ASL-Robot/pcb-design/PCB_BOM.xlsx

Sheet: BOM
 | Digikey Item Number | Name | Function | Quantity per PCB | 3xQuantity Per PCB | Unit Price | Total Cost
Voltage Regulators | 1028-1214-1-ND | RT7258 | 8A Switching Regulator | 13 | 39 | $0.97 | $37.81
 | IRF7821PBFCT-ND | IRF7821 | N-Ch MOSFET | 13 | 39 | $0.92 | $35.69
 | 311-2054-1-ND | 47 uF Capacitor | Reservoir Capacitors | 38 | 114 | $0.46 | $52.85
 | 445-11739-1-ND | 22 uF Capacitor | Input Filter Capacitor | 13 | 39 | $0.50 | $19.50
 | 490-11607-1-ND | 1 uF Capcaitor | Vcc Decoupling & Boot Capacitors | 26 | 78 | $0.22 | $17.32
 | 595-1400-1-ND | 10 uH Inductor |  | 13 | 39 | $0.74 | $29.02
 | RHM60.4KCJCT-ND | 60.4k Resistor | 3.3 V Feedback Resistor (R1) | 1 | 3 | $0.10 | $0.30
 | RHM19.6KCJCT-ND | 19.6k Resistor | 3.3 V Feedback Resistor (R2) | 1 | 3 | $0.10 | $0.30
 | RHM82.0KCJCT-ND | 82k Resistor | 5 V Feedback Resistor (R1) | 1 | 3 | $0.10 | $0.30
 | RHM16.0KCJCT-ND | 16k Resistor | 5 V Feedback Resistor (R2) | 1 | 3 | $0.10 | $0.30
 | RHM133KCJCT-ND | 133k Resistor | 7.4 V Feedback Resistor (R1) | 2 | 6 | $0.10 | $0.60
 | RHM16.2KCJCT-ND | 16.2k Resistor | 7.4 V Feedback Resistor (R2) | 2 | 6 | $0.10 | $0.60
 | RHM121KCJCT-ND | 121k Resistor | 11.1 V Feedback Resistor (R1) | 1 | 3 | $0.10 | $0.30
 | RHM9.53KCJCT-ND | 9.53k Resistor | 11.1 V Feedback Resistor (R2) | 1 | 3 | $0.10 | $0.30
 | RHM127KCJCT-ND | 127k Resistor | 12.0 V Feedback Resistor (R1) | 8 | 24 | $0.10 | $2.40
 | RHM9.10KCJCT-ND | 9.1k Resistor | 12.0 V Feedback Resistor (R2) | 8 | 24 | $0.10 | $2.40
 | RHM390CJCT-ND | 390 | EN Resistor Network (R1) | 1 | 3 | $0.10 | $0.30
 | RHM100CJCT-ND | 100 | EN Resistor Network (R2) | 1 | 3 | $0.10 | $0.30
Circuit Protection | 486-1258-ND | Fuse Holder |  | 18 | 54 | $0.64 | $34.56
 | F2392-ND | 1A Fuse | 5V & 3V rails | 2 | 6 | $0.36 | $2.16
 | F2393-ND | 2A Fuse | 11.1 V Pin Headers | 2 | 6 | $0.36 | $2.16
 | F2682-ND | 3A Fuse | 7.4V Pin Headers | 6 | 18 | $0.40 | $7.15
 | 486-1791-ND | 10A Fuse | 12V Rails | 8 | 24 | $1.11 | $26.74
 | 732-9776-1-ND | 14V vwm TVS Diode | 12V Rail Clamping Protection | 8 | 24 | $0.30 | $7.20
 | 732-9774-1-ND | 12V vwm TVS Diode | 11.1V Rail Clamping Protection | 1 | 3 | $0.33 | $0.99
 | 732-9734-1-ND | 8V vwm TVS Diode | 7.4 V Rail Clamping Protection | 2 | 6 | $0.33 | $1.98
 | 732-9764-1-ND | 5V vwm TVS Diode | 5 V Rail Clamping Protection | 1 | 3 | $0.33 | $0.99
 | SMBJ3V3-E3/52GICT-ND | 3.3V vwm TVS Diode | 3.3V Rail Clamping Protection | 1 | 3 | $0.41 | $1.23
 | 404-1037-1-ND |  | Status LED's | 31 | 93 | $0.27 | $24.70
 | RHM750CJCT-ND | 750 Resistor | Power Status LED Resistor | 13 | 39 | $0.10 | $3.90
 | RHM499CJCT-ND | 499 Resistor | 12V Rail Status LED Resistor | 8 | 24 | $0.05 | $1.30
 | RHM453CJCT-ND | 453 Resistor | 11.1V Rail Status LED Resistor | 2 | 6 | $0.10 | $0.60
 | RHM267CJCT-ND | 267 Resistor | 7.4 V Rail Status LED Resistor | 6 | 18 | $0.10 | $1.80
 | RHM147CJCT-ND | 147 Resistor | 5V Rail Status LED Resistor | 1 | 3 | $0.10 | $0.30
 | RHM59CJCT-ND | 59 Resistor | 3.3V Rail Status LED Resistor | 1 | 3 | $0.10 | $0.30
 | IPD068P03L3 GCT-ND | P-CH Mosfet | Reverse Current Protection | 5 | 15 | $0.76 | $11.40
Power Relay Switch | A122116-ND | Relay | Power Relay | 1 | 3 | $43.04 | $129.12
 | A121979-ND | Seal | Power Relay Wire Seal | 4 | 12 | $0.20 | $2.40
 | A106529-ND | Plug | Connector Plug for Relay | 1 | 3 | $1.85 | $5.55
 | A105220CT-ND | Crimp | Connector Socket for Relay | 4 | 12 | $0.34 | $4.08
 | BH9VW-ND | Battery Holder | 9 V Battery Casing | 1 | 3 | $1.43 | $4.29
 | 432-1086-ND | Switch | On/Off Switch for Relay | 1 | 3 | $4.68 | $14.04
 | A100746CT-ND | Crimp | O-Ring Load Connector | 3 | 9 | $0.57 | $5.13
Signal Circuit | Can only get from TI (http://www.ti.com/product/msp432p401r/samplebuy) | MSP432 | Micro-controller | 2 | 6 | $7.60 | $45.60
 | 296-1232-1-ND | Transceivever | Tri-state Buffer | 2 | 6 | $0.50 | $3.00
 | 587-1624-1-ND | 4.7 uH Inductor |  | 2 | 6 | $0.27 | $1.62
 | 1276-1148-1-ND | 10uF Capacitor | Ceramic | 2 | 6 | $0.23 | $1.38
 | 490-1805-1-ND | 4.7 uF Capacitor | Ceramic | 2 | 6 | $0.25 | $1.50
 | 490-11607-1-ND | 1 uF Capacitor | Ceramic | 4 | 12 | $0.30 | $3.60
 | 399-1249-1-ND | 100 nF Capacitor | Ceramic | 10 | 30 | $0.07 | $2.16
 | RHM200CJCT-ND | 200 Ω Resistor |  | 1 | 3 | $0.10 | $0.30
 | RHM10.0KCJCT-ND | 10K Ω Resistor |  | 1 | 3 | $0.10 | $0.30
 | 2863S-08-ND | 8 POS | PCB Pin Socket | 2 | 6 | $1.39 | $8.34
 | S5901-03-ND | 3 POS | PCB Pin Socket | 1 | 3 | $8.40 | $25.20
Connectors | WM19010-ND | Wire Housing | XL-320 Cable | 12 | 36 | $0.11 | $4.10
 | WM19005-ND | PCB Header | XL-320 Cable | 6 | 18 | $0.18 | $3.17
 | WM4561CT-ND | Crimp | XL-320 Cable | 36 | 108 | $0.04 | $4.28
 | WM18874-ND | Wire Housing | MX/AX Cable | 32 | 96 | $0.23 | $22.44
 | WM18887-ND | PCB Header | MX/AX Cable | 4 | 12 | $0.47 | $5.68
 | WM18889CT-ND | Crimp | MX/AX Cable | 96 | 288 | $0.06 | $16.31
 | 277-1860-ND | 4-Pos (3.5) Terminal Block | Relay to Voltage Regulator Input Connection | 3 | 9 | $0.75 | $6.75
 | 277-6699-ND | 1-Pos Terminal Block | PCB Ground Connection | 1 | 3 | $3.80 | $11.40
 | 311-0.0ERCT-ND | 0 Ω Resistor | PCB Track Jumpers | 16 | 48 | $0.02 | $0.84
 |  |  |  |  |  | $220.87 | $662.62

Sheet: Inductor-Resistor Calculations
Vin Max (V) | I Max (A) | Frequency (kHz)
24 | 8 | 600
Inductance Calculation |  |  | Feedback Resistor Network Calculations
Vout | Min. Inductance (uH) |  | R1 Calculation |  |  |  | R2 Calculation |  |  | Vout Calculation
3.3 | 2.47 |  | R2 (kΩ) | Vout | R1 (kΩ) |  | R1 (kΩ) | Vout | R2 (kΩ) | R1 (kΩ) | R2 (kΩ) | Vout
5 | 3.44 |  | 20 | 3.3 | 61.68316832 |  | 62 | 3.3 | 20.10272873 | 60.4 | 19.6 | 3.297959184
7.4 | 4.44 |  | 16 | 5 | 83.00990099 |  | 93 | 5 | 17.92557252 | 82 | 16 | 4.949
11.1 | 5.18 |  | 16 | 7.4 | 130.5346535 |  | 133 | 7.4 | 16.30218447 | 133 | 16.2 | 7.441580247
12 | 5.21 |  | 9.1 | 11.1 | 115.9123762 |  | 121 | 11.1 | 9.499417023 | 121 | 9.53 | 11.06697167
 |  |  | 9.1 | 12 | 126.0485149 |  |  | 12 | 0 | 127 | 9.1 | 12.08448352
 |  |  |  |  |  |  |  |  |  | Final Values
 |  |  | Status Led Resistor Calculation
 |  |  | Vdiode (V) | I diode (mA) |  | Vcc | Resistor ()
 |  |  | 2.1 | 20 |  | 24 | 1095
 |  |  |  |  |  | 15 | 645
 |  |  |  |  |  | 12 | 495
 |  |  |  |  |  | 11.1 | 450
 |  |  |  |  |  | 7.4 | 265
 |  |  |  |  |  | 5 | 145
 |  |  |  |  |  | 3.3 | 60

Sheet: Current(A) Calculations
Motor | Rec. Voltage (V) | Max Current Draw (A) | Quantity | Total Current Draw (A)
XL-320 | 7.4 | 0.6 | 22 | 13.2
AX-12 | 11.1 | 1.5 | 2 | 3
MX-28 | 12 | 1.4 | 2 | 2.8
MX-64 | 12 | 4.1 | 2 | 8.2
MX-106 | 12 | 5.2 | 10 | 52
 |  |  |  | 79.2
Voltage | Total Current Draw | # of 8A Voltage Regulators
7.4 | 13.2 | 2
11.1 | 3 | 1
12 | 63 | 8
