ASL-Robot/pcb-design/PCBFinal/PCBFinal.kicad_pcb

## KiCad design PCBFinal/PCBFinal.kicad_pcb (2016-05-11)

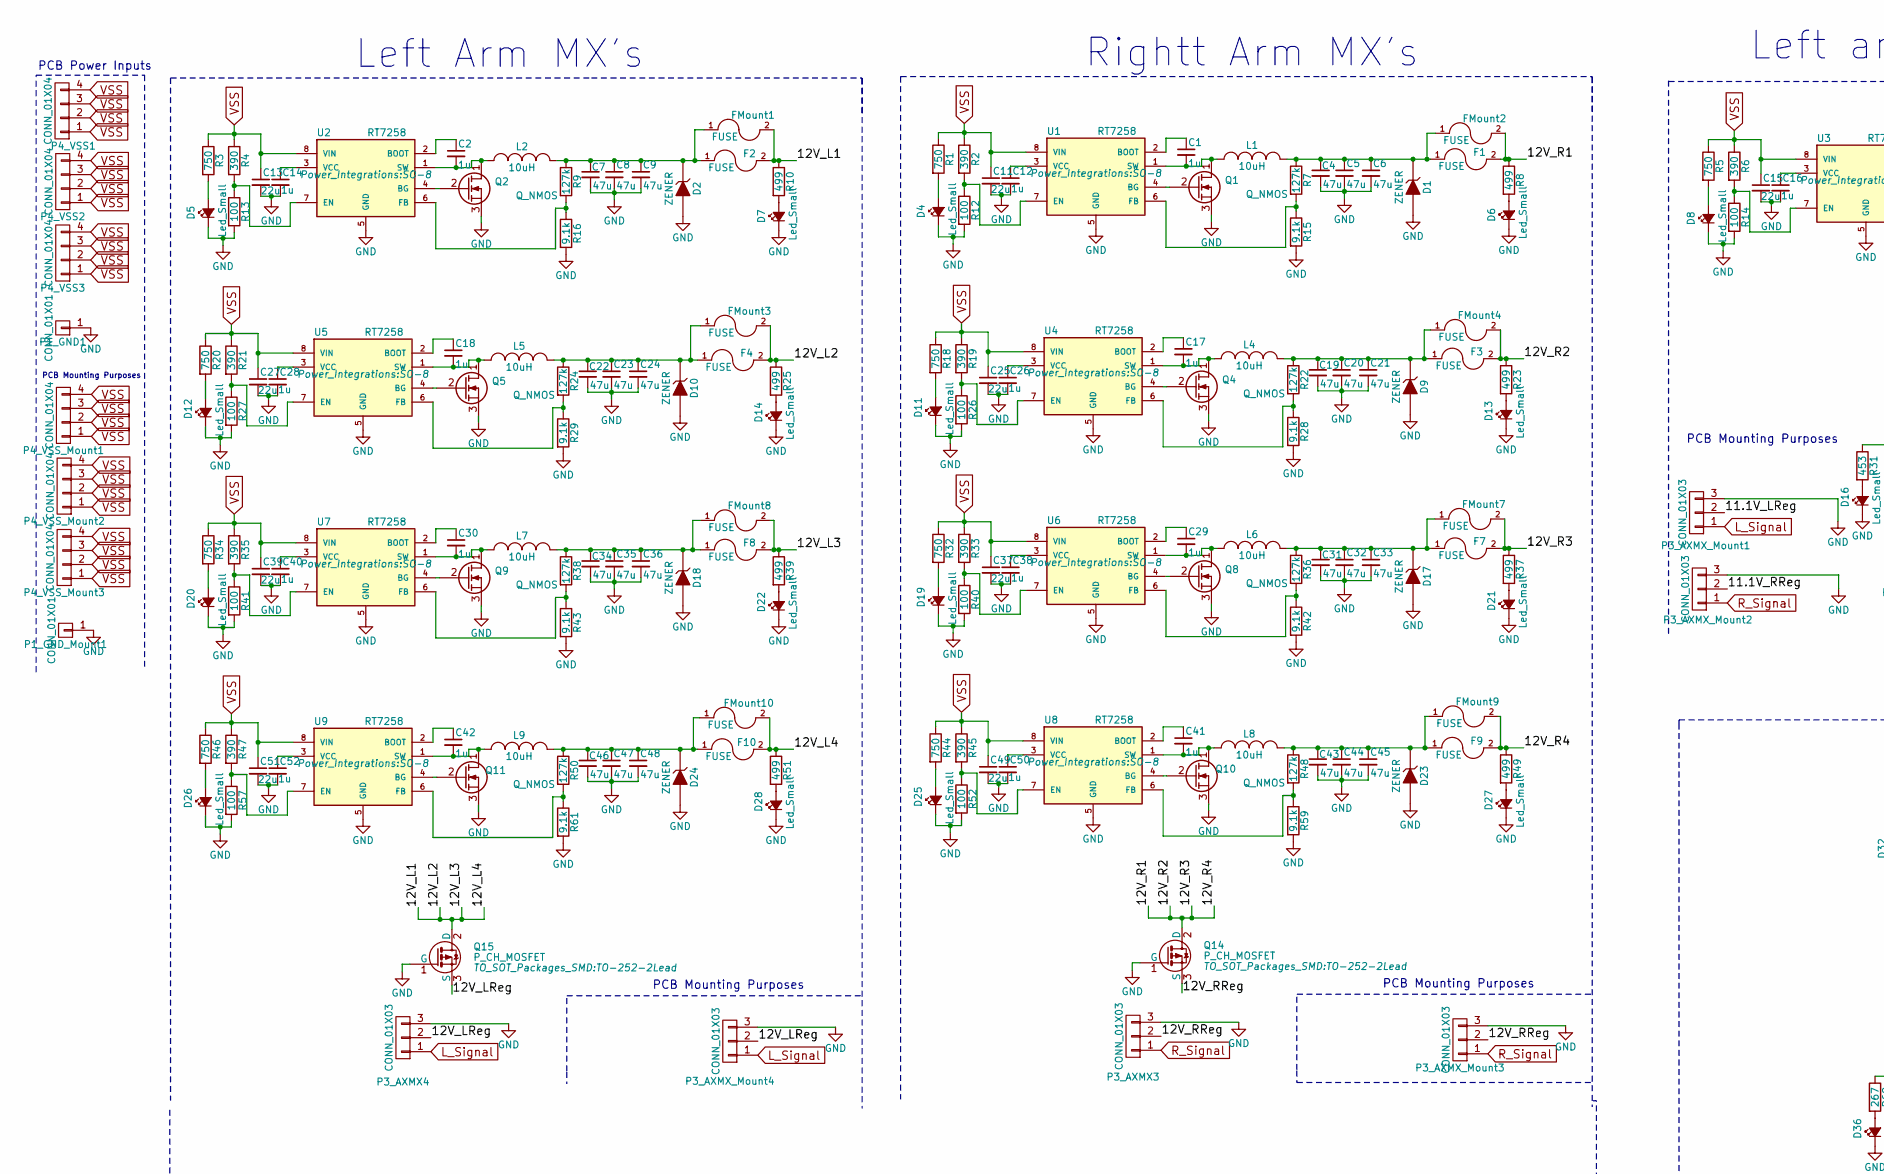
[picture p1: schematic PCBFinal.sch, part in row 1, column 1]

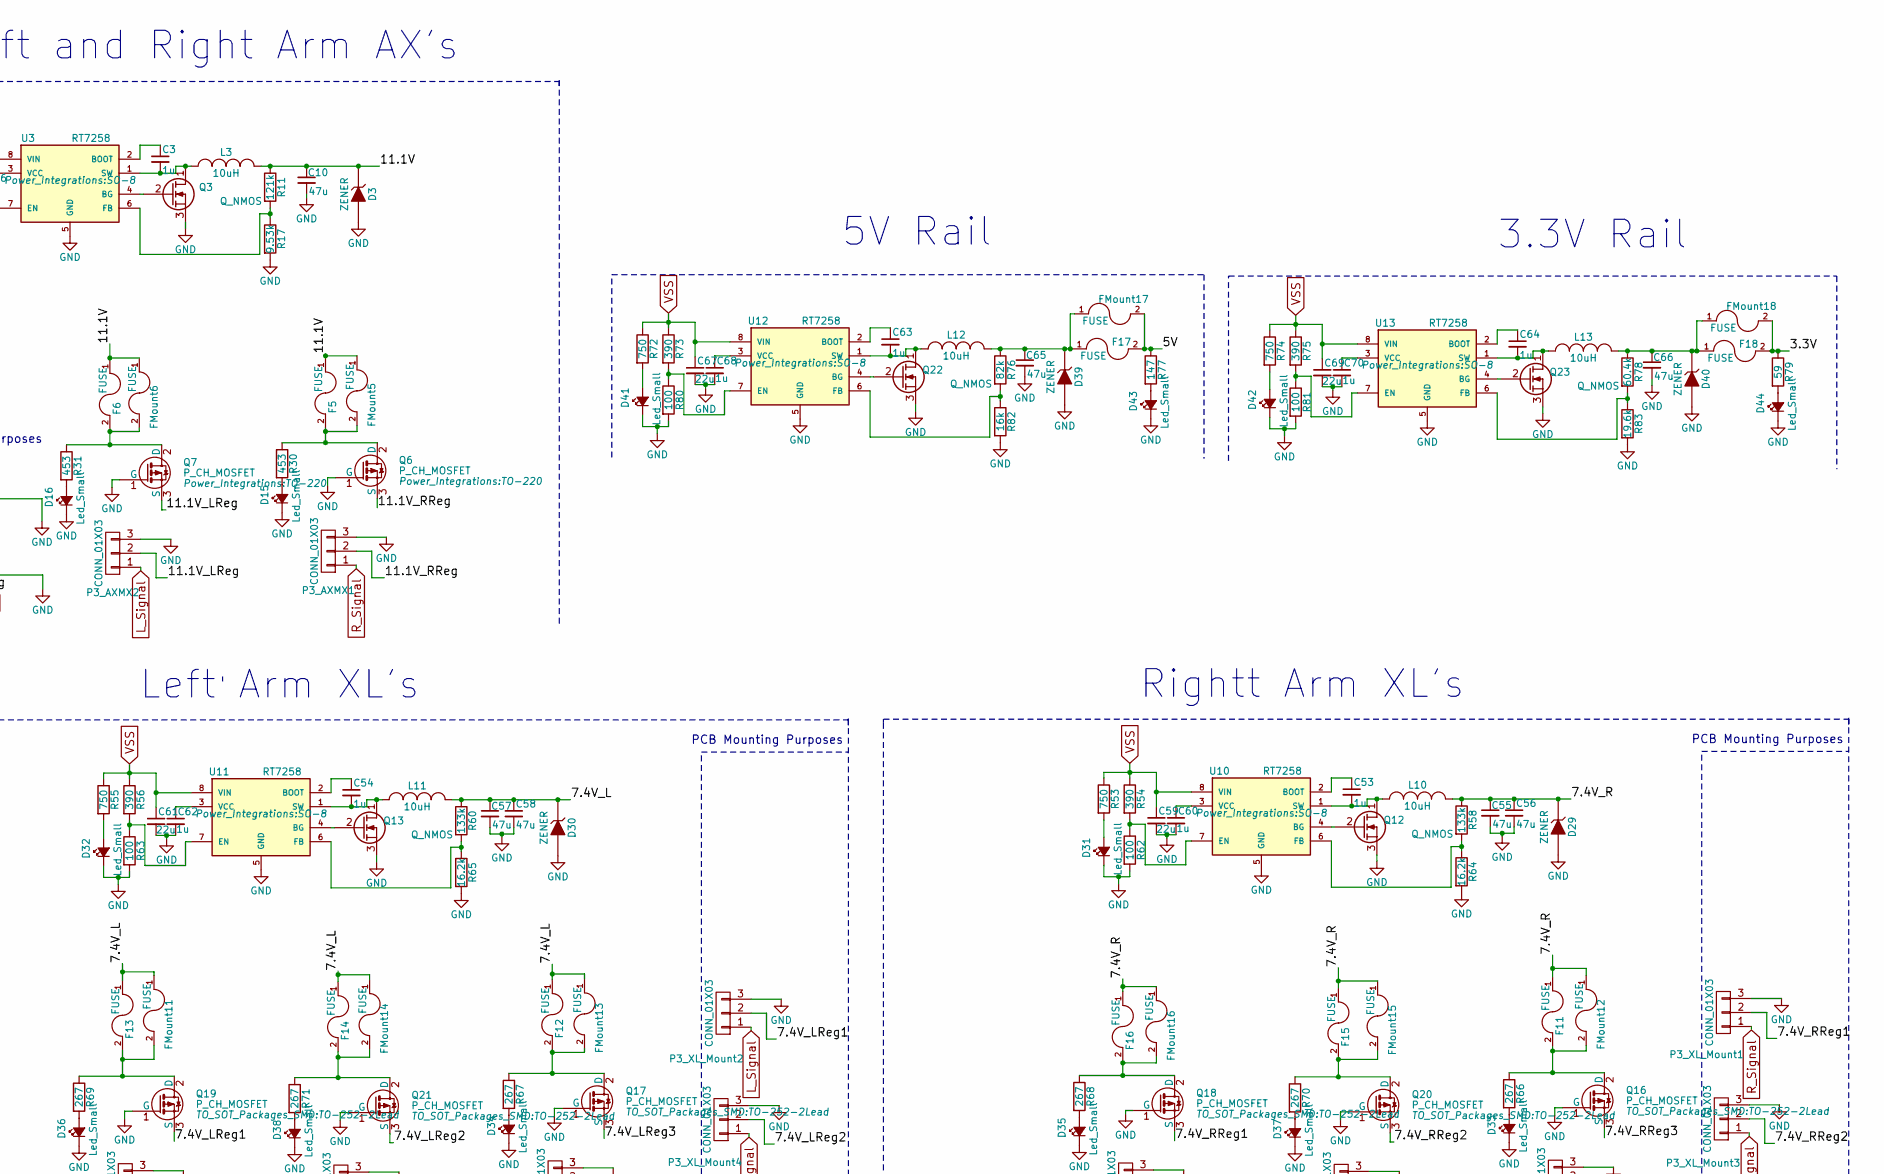
[picture p2: schematic PCBFinal.sch, part in row 1, column 2]

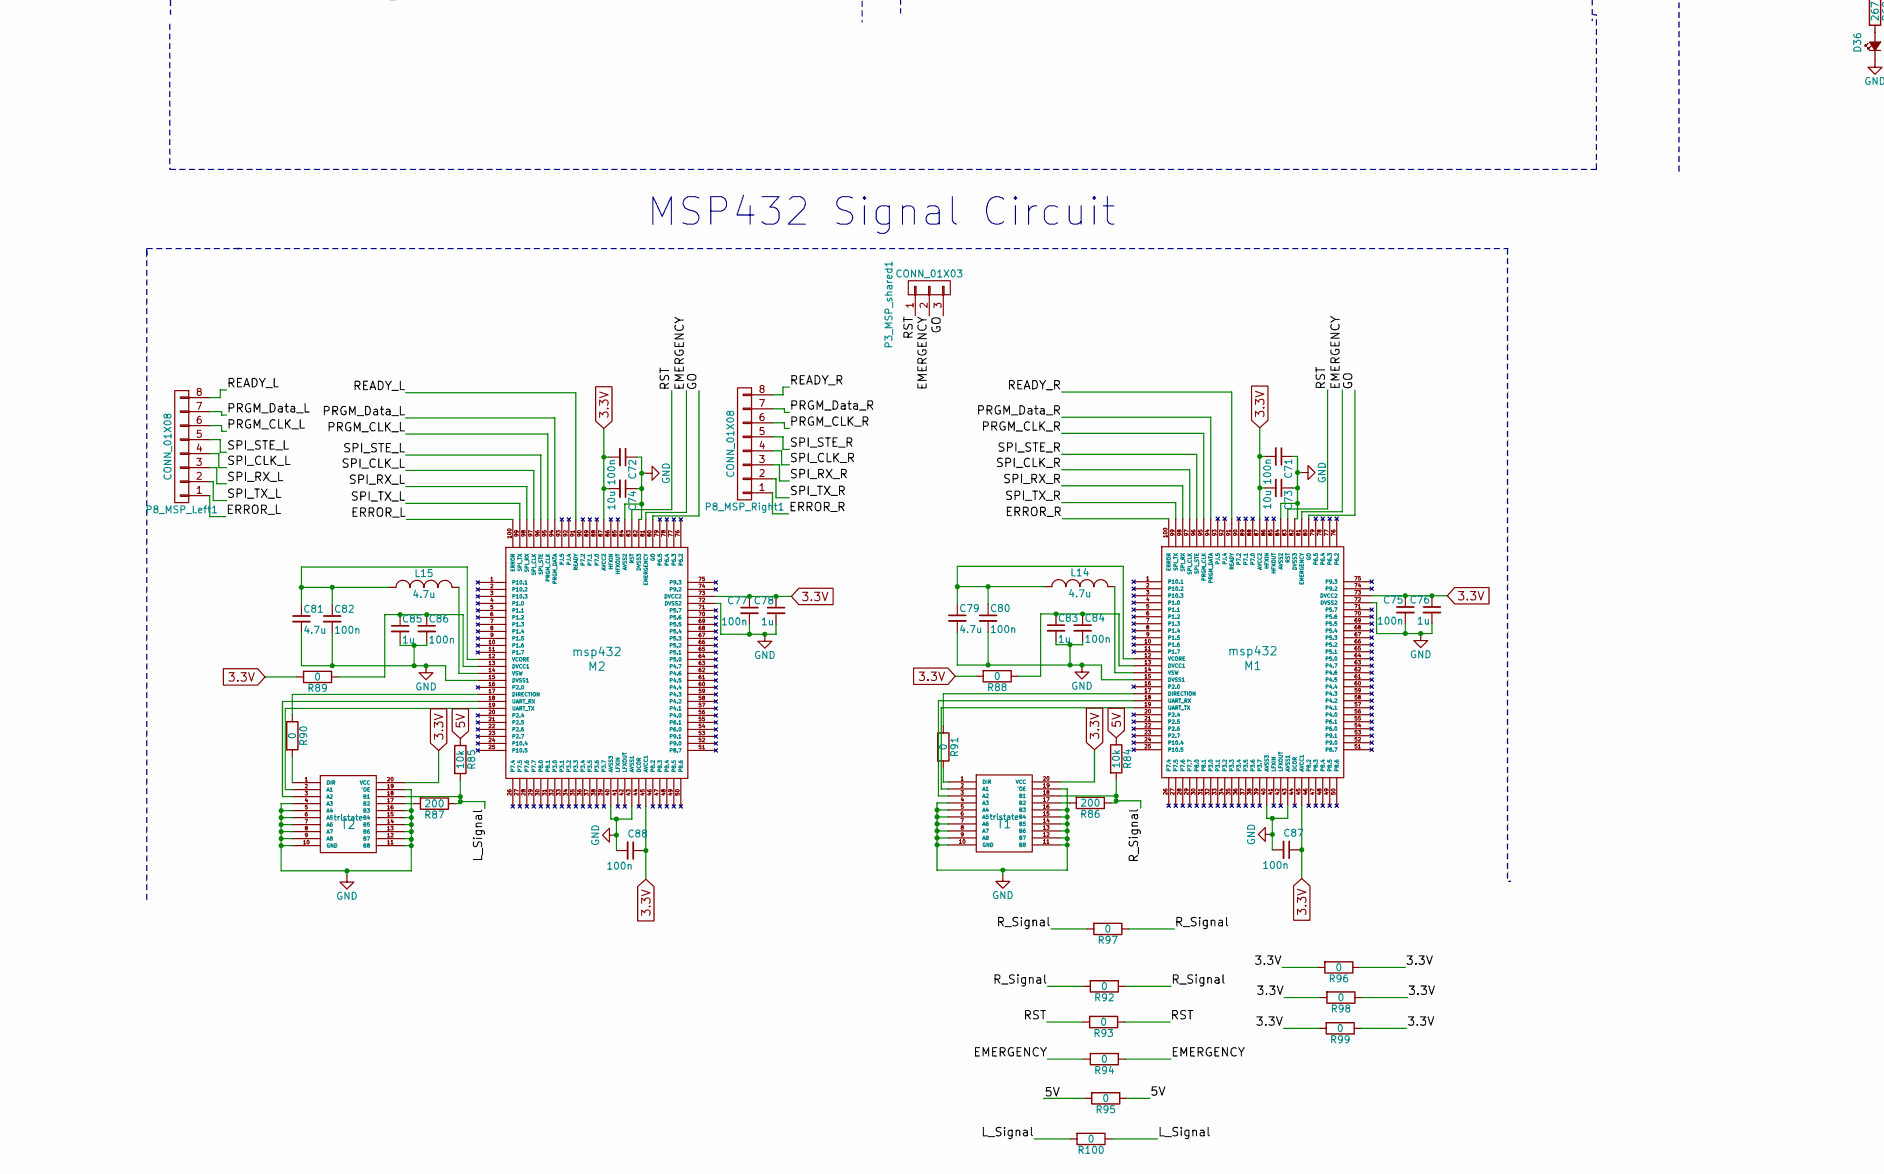
[picture p3: schematic PCBFinal.sch, part in row 2, column 1]

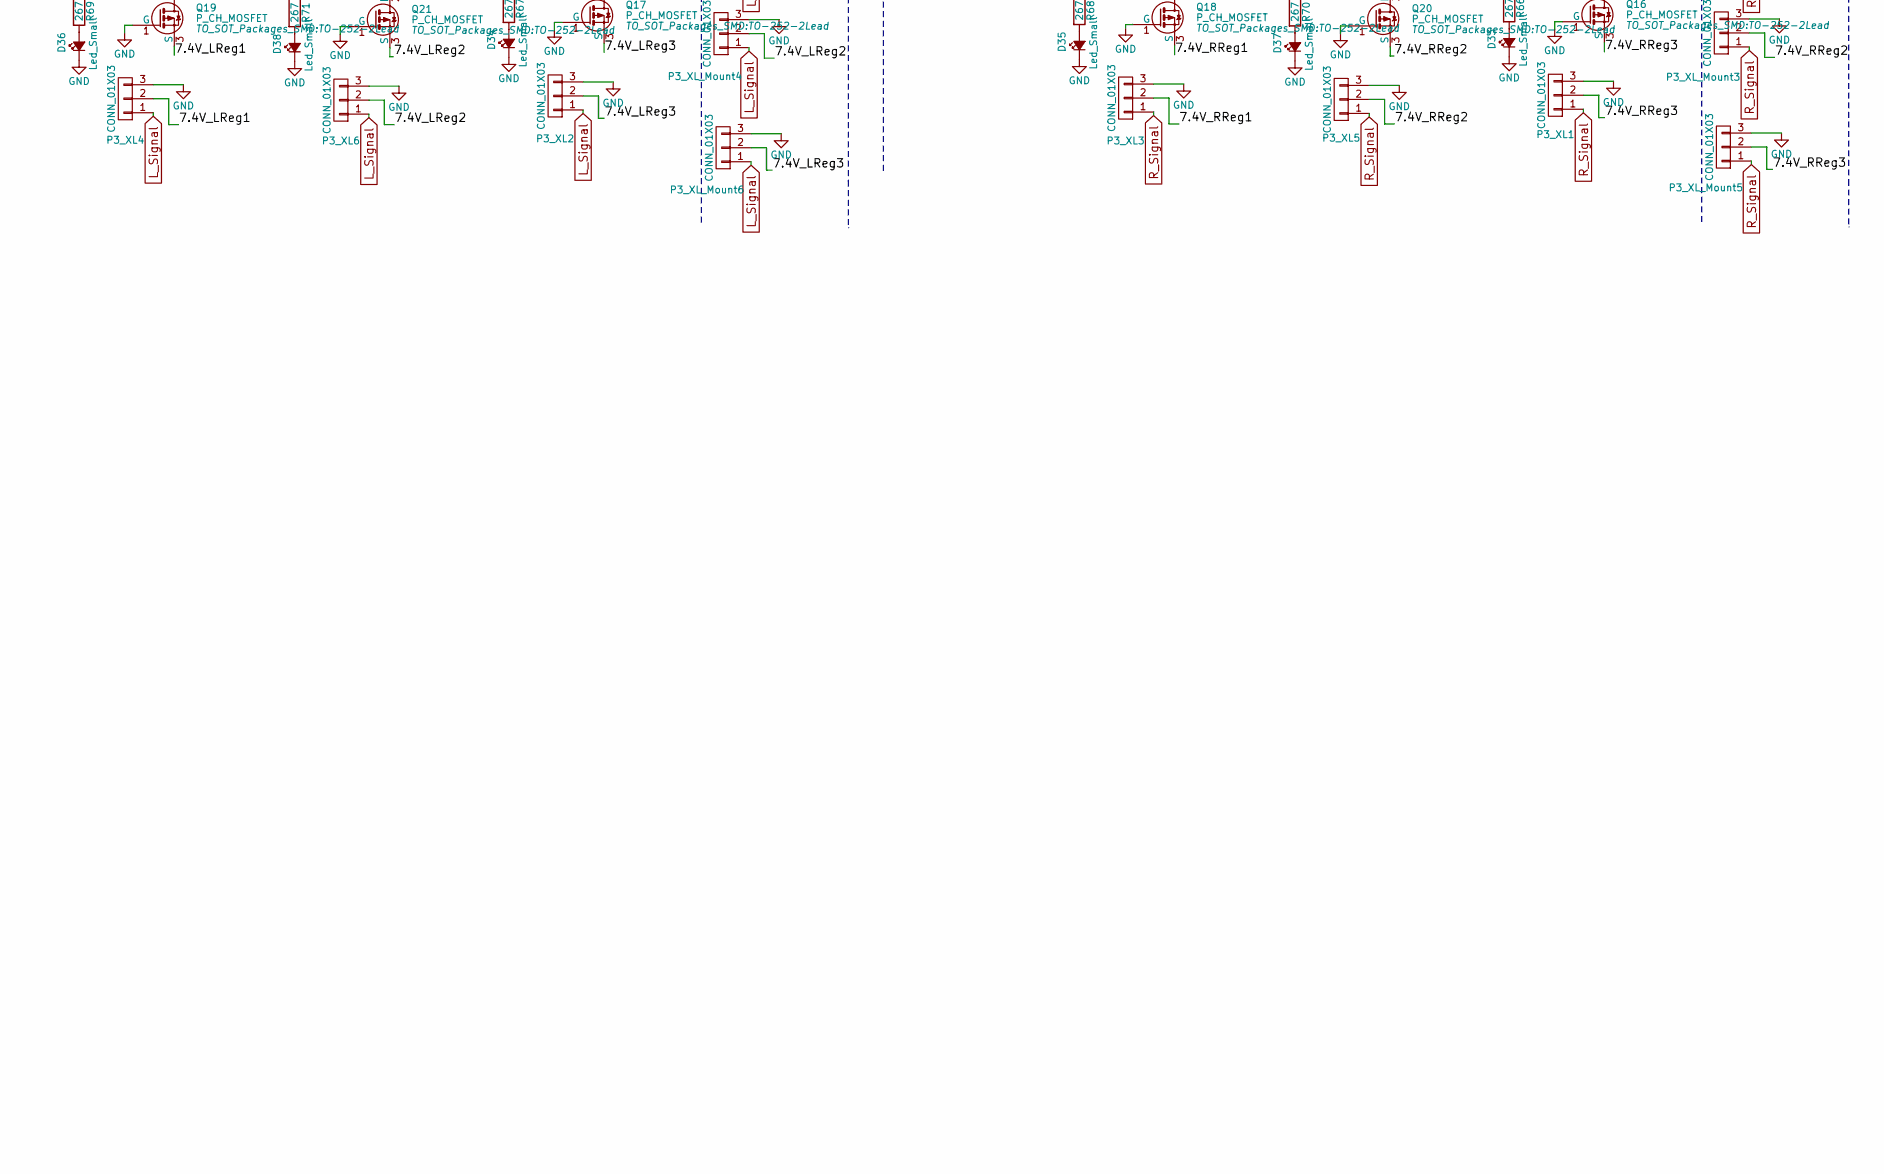
[picture p4: schematic PCBFinal.sch, part in row 2, column 2]

Parts:
C1, C2, C3, C12, C14, C16, C17, C18, C26, C28, C29, C30, C38, C40, C41, C42, C50, C52, C53, C54, C60, C62, C63, C64, C68, C76, C78, C83, C85: 1u; C_1206_HandSoldering
C4, C5, C7, C8, C9, C10, C19, C20, C21, C22, C23, C24, C31, C32, C33, C34, C35, C36, C43, C44, C45, C46, C47, C48, C55, C56, C57, C58: 47u; C_1210_HandSoldering
C6: 47u; Q_NMOS
C11, C13, C15, C25, C27, C37, C39, C49, C51, C59, C61, C67: 22u; C_1206_HandSoldering
C65, C66: 47u; C_1206_HandSoldering
C69: 22u; C_1210_HandSoldering
C70: 1u; C_1210_HandSoldering
C71, C72, C75, C77, C80, C82, C84, C86, C87, C88: 100n; C_1206_HandSoldering
C73, C74: 10u; C_1206_HandSoldering
C79, C81: 4.7u; C_1206_HandSoldering
D1, D2, D3, D9, D10, D17, D18, D23, D24, D29, D30, D39, D40: ZENER; SMB_Handsoldering
D4, D5, D6, D7, D8, D11, D12, D13, D14, D15, D16, D19, D20, D21, D22, D25, D26, D27, D28, D31, D32, D33, D34, D35, D36, D37, D38, D41, D42, D43, D44: Led_Small; R_1206_HandSoldering
F1, F2, F3, F4, F5, F6, F7, F8, F9, F10, F11, F12, F13, F14, F15, F16, F17, F18: FUSE; Fuseholder5x20_horiz_open_Schurter_0031_8201
FMount1, FMount2, FMount3, FMount4, FMount5, FMount6, FMount7, FMount8, FMount9, FMount10, FMount11, FMount12, FMount13, FMount14, FMount15, FMount16, FMount17, FMount18: FUSE; FuseholderThroughHoles
L1, L2, L3, L4, L5, L6, L7, L8, L9, L10, L11, L12, L13: 10uH; 10uHInductor
L14, L15: 4.7u; C_1206_HandSoldering
M1, M2: msp432; LQFP-100_14x14mm_Pitch0.5mm
P1_GND1: CONN_01X01; GND_CONN
P1_GND_Mount1: CONN_01X01; GND_CONN_Holes
P3_AXMX1, P3_AXMX2, P3_AXMX3, P3_AXMX4: CONN_01X03; Pin_Header_Straight_1x03
P3_AXMX_Mount1, P3_AXMX_Mount2, P3_AXMX_Mount3, P3_AXMX_Mount4: CONN_01X03; Pin_Header_Straight_1x03_Holes
P3_MSP_shared1, P3_XL1, P3_XL2, P3_XL3, P3_XL4, P3_XL5, P3_XL6: CONN_01X03; Pin_Header_Straight_1x03_Pitch2.00mm
P3_XL_Mount1, P3_XL_Mount2, P3_XL_Mount3, P3_XL_Mount4, P3_XL_Mount5, P3_XL_Mount6: CONN_01X03; Pin_Header_Straight_1x03_Pitch2.00mm_Holes
P4_VSS1, P4_VSS2, P4_VSS3: CONN_01X04; TerminalBlock_Pheonix_PT-3.5mm_4pol
P4_VSS_Mount1, P4_VSS_Mount2, P4_VSS_Mount3: CONN_01X04; TerminalBlock_Pheonix_PT-3.5mm_4pol_Holes
P8_MSP_Left1, P8_MSP_Right1: CONN_01X08; Pin_Header_Straight_1x08_Pitch2.00mm_SMD
Q1, Q2, Q3, Q4, Q5, Q8, Q9, Q10, Q11, Q12, Q13, Q22, Q23: Q_NMOS
Q6, Q7: P_CH_MOSFET; TO-220
Q14, Q15, Q16, Q17, Q18, Q19, Q20, Q21: P_CH_MOSFET; TO-252-2Lead
R1, R3, R5, R18, R20, R32, R34, R44, R46, R53, R55, R72, R74: 750; R_1206_HandSoldering
R2, R4, R6, R19, R21, R33, R35, R45, R47, R54, R56, R73, R75: 390; R_1206_HandSoldering
R7, R9, R22, R24, R36, R38, R48, R50: 127k; R_1206_HandSoldering
R8, R10, R23, R25, R37, R39, R49, R51: 499; R_1206_HandSoldering
R11: 121k; R_1206_HandSoldering
R12, R13, R14, R26, R27, R40, R41, R52, R57, R62, R63, R80, R81: 100; R_1206_HandSoldering
R15, R16, R28, R29, R42, R43, R59, R61: 9.1k; R_1206_HandSoldering
R17: 9.53k; R_1206_HandSoldering
R30, R31: 453; R_1206_HandSoldering
R58, R60: 133k; R_1206_HandSoldering
R64, R65: 16.2k; R_1206_HandSoldering
R66, R67, R68, R69, R70, R71: 267; R_1206_HandSoldering
R76: 82k; R_1206_HandSoldering
R77: 147; R_1206_HandSoldering
R78: 60.4k; R_1206_HandSoldering
R79: 59; R_1206_HandSoldering
R82: 16k; R_1206_HandSoldering
R83: 19.6k; R_1206_HandSoldering
R84, R85: 10k; R_1206_HandSoldering
R86, R87: 200; R_1206_HandSoldering
R88, R89, R90, R91, R92, R93, R94, R95, R96, R97, R98, R99, R100: 0; R_1206_HandSoldering
T1, T2: tristate; SOIC-20_7.5x12.8mm_Pitch1.27mm
U1, U2, U3, U4, U5, U6, U7, U8, U9, U10, U11, U12, U13: RT7258; SO-8

Connections:
3.3V: C71.2, C72.2, C73.2, C74.2, C75.1, C76.1, C77.1, C78.1, C87.1, C88.1, F18.2, FMount18.2, M1.45 (AVCC1), M1.73 (DVCC2), M1.87 (AVCC2), M2.45 (AVCC1), M2.73 (DVCC2), M2.87 (AVCC2), R79.1, R88.2, R89.2, R96.1, R96.2, R98.1, R98.2, R99.1, R99.2, T1.20 (VCC), T2.20 (VCC)
5V: F17.2, FMount17.2, R77.1, R84.1, R85.1, R95.1, R95.2
/7.4V_L: C57.1, C58.1, D30.1 (K), F12.1, F13.1, F14.1, FMount11.1, FMount13.1, FMount14.1, L11.2, R60.1
/7.4V_LReg1: P3_XL4.2, P3_XL_Mount2.2, Q19.3 (S)
/7.4V_LReg2: P3_XL6.2, P3_XL_Mount4.2, Q21.3 (S)
/7.4V_LReg3: P3_XL2.2, P3_XL_Mount6.2, Q17.3 (S)
/7.4V_R: C55.1, C56.1, D29.1 (K), F11.1, F15.1, F16.1, FMount12.1, FMount15.1, FMount16.1, L10.2, R58.1
/7.4V_RReg1: P3_XL3.2, P3_XL_Mount1.2, Q18.3 (S)
/7.4V_RReg2: P3_XL5.2, P3_XL_Mount3.2, Q20.3 (S)
/7.4V_RReg3: P3_XL1.2, P3_XL_Mount5.2, Q16.3 (S)
/11.1V: C10.1, D3.1 (K), F5.1, F6.1, FMount5.1, FMount6.1, L3.2, R11.1
/11.1V_LReg: P3_AXMX2.2, P3_AXMX_Mount1.2, Q7.3 (S)
/11.1V_RReg: P3_AXMX1.2, P3_AXMX_Mount2.2, Q6.3 (S)
/12V_L1: F2.2, F4.2, F8.2, F10.2, FMount1.2, FMount3.2, FMount8.2, FMount10.2, Q15.2 (D), R10.1, R25.1, R39.1, R51.1
/12V_LReg: P3_AXMX4.2, P3_AXMX_Mount4.2, Q15.3 (S)
/12V_R1: F1.2, F3.2, F7.2, F9.2, FMount2.2, FMount4.2, FMount7.2, FMount9.2, Q14.2 (D), R8.1, R23.1, R37.1, R49.1
/12V_RReg: P3_AXMX3.2, P3_AXMX_Mount3.2, Q14.3 (S)
/EMERGENCY: M1.81 (EMERGENCY), M2.81 (EMERGENCY), P3_MSP_shared1.2, R94.1, R94.2
/ERROR_L: M2.100 (ERROR), P8_MSP_Left1.1
/ERROR_R: M1.100 (ERROR), P8_MSP_Right1.1
/GO: M1.80 (GO), M2.80 (GO), P3_MSP_shared1.3
/PRGM_CLK_L: M2.95 (PRGM_CLK), P8_MSP_Left1.6
/PRGM_CLK_R: M1.95 (PRGM_CLK), P8_MSP_Right1.6
/PRGM_Data_L: M2.94 (PRGM_DATA), P8_MSP_Left1.7
/PRGM_Data_R: M1.94 (PRGM_DATA), P8_MSP_Right1.7
/READY_L: M2.91 (READY), P8_MSP_Left1.8
/READY_R: M1.91 (READY), P8_MSP_Right1.8
/RST: M1.83 (RST), M2.83 (RST), P3_MSP_shared1.1, R93.1, R93.2
/SPI_CLK_L: M2.97 (SPI_CLK), P8_MSP_Left1.4
/SPI_CLK_R: M1.97 (SPI_CLK), P8_MSP_Right1.4
/SPI_RX_L: M2.98 (SPI_RX), P8_MSP_Left1.3
/SPI_RX_R: M1.98 (SPI_RX), P8_MSP_Right1.3
/SPI_STE_L: M2.96 (SPI_STE), P8_MSP_Left1.5
/SPI_STE_R: M1.96 (SPI_STE), P8_MSP_Right1.5
/SPI_TX_L: M2.99 (SPI_TX), P8_MSP_Left1.2
/SPI_TX_R: M1.99 (SPI_TX), P8_MSP_Right1.2
GND: C4.2, C5.2, C6.2, C7.2, C8.2, C9.2, C10.2, C11.2, C12.2, C13.2, C14.2, C15.2, C16.2, C19.2, C20.2, C21.2, C22.2, C23.2, C24.2, C25.2, C26.2, C27.2, C28.2, C31.2, C32.2, C33.2, C34.2, C35.2, C36.2, C37.2, C38.2, C39.2, C40.2, C43.2, C44.2, C45.2, C46.2, C47.2, C48.2, C49.2, C50.2, C51.2, C52.2, C55.2, C56.2, C57.2, C58.2, C59.2, C60.2, C61.2, C62.2, C65.2, C66.2, C67.2, C68.2, C69.2, C70.2, C71.1, C72.1, C73.1, C74.1, C75.2, C76.2, C77.2, C78.2, C79.2, C80.2, C81.2, C82.2, C83.2, C84.2, C85.2, C86.2, C87.2, C88.2, D1.2 (A), D2.2 (A), D3.2 (A), D4.1 (K), D5.1 (K), D6.1 (K), D7.1 (K), D8.1 (K), D9.2 (A), D10.2 (A), D11.1 (K), D12.1 (K), D13.1 (K), D14.1 (K), D15.1 (K), D16.1 (K), D17.2 (A), D18.2 (A), D19.1 (K), D20.1 (K), D21.1 (K), D22.1 (K), D23.2 (A), D24.2 (A), D25.1 (K), D26.1 (K), D27.1 (K), D28.1 (K), D29.2 (A), D30.2 (A), D31.1 (K), D32.1 (K), D33.1 (K), D34.1 (K), D35.1 (K), D36.1 (K), D37.1 (K), D38.1 (K), D39.2 (A), D40.2 (A), D41.1 (K), D42.1 (K), D43.1 (K), D44.1 (K), M1.15 (DVSS1), M1.40 (AVSS3), M1.43 (AVSS1), M1.72 (DVSS2), M1.82 (DVSS3), M1.84 (AVSS2), M2.15 (DVSS1), M2.40 (AVSS3), M2.43 (AVSS1), M2.72 (DVSS2), M2.82 (DVSS3), M2.84 (AVSS2), P1_GND1.1, P1_GND_Mount1.1, P3_AXMX1.3, P3_AXMX2.3, P3_AXMX3.3, P3_AXMX4.3, P3_AXMX_Mount1.3, P3_AXMX_Mount2.3, P3_AXMX_Mount3.3, P3_AXMX_Mount4.3, P3_XL1.3, P3_XL2.3, P3_XL3.3, P3_XL4.3, P3_XL5.3, P3_XL6.3, P3_XL_Mount1.3, P3_XL_Mount2.3, P3_XL_Mount3.3, P3_XL_Mount4.3, P3_XL_Mount5.3, P3_XL_Mount6.3, Q1.3 (S), Q2.3 (S), Q3.3 (S), Q4.3 (S), Q5.3 (S), Q6.1 (G), Q7.1 (G), Q8.3 (S), Q9.3 (S), Q10.3 (S), Q11.3 (S), Q12.3 (S), Q13.3 (S), Q14.1 (G), Q15.1 (G), Q16.1 (G), Q17.1 (G), Q18.1 (G), Q19.1 (G), Q20.1 (G), Q21.1 (G), Q22.3 (S), Q23.3 (S), R12.2, R13.2, R14.2, R15.2, R16.2, R17.2, R26.2, R27.2, R28.2, R29.2, R40.2, R41.2, R42.2, R43.2, R52.2, R57.2, R59.2, R61.2, R62.2, R63.2, R64.2, R65.2, R80.2, R81.2, R82.2, R83.2, T1.4 (A3), T1.5 (A4), T1.6 (A5), T1.7 (A6), T1.8 (A7), T1.9 (A8), T1.10 (GND), T1.11 (B8), T1.12 (B7), T1.13 (B6), T1.14 (B5), T1.15 (B4), T1.16 (B3), T1.19 ('OE), T2.4 (A3), T2.5 (A4), T2.6 (A5), T2.7 (A6), T2.8 (A7), T2.9 (A8), T2.10 (GND), T2.11 (B8), T2.12 (B7), T2.13 (B6), T2.14 (B5), T2.15 (B4), T2.16 (B3), T2.19 ('OE), U1.5 (GND), U2.5 (GND), U3.5 (GND), U4.5 (GND), U5.5 (GND), U6.5 (GND), U7.5 (GND), U8.5 (GND), U9.5 (GND), U10.5 (GND), U11.5 (GND), U12.5 (GND), U13.5 (GND)
L_Signal: P3_AXMX2.1, P3_AXMX4.1, P3_AXMX_Mount1.1, P3_AXMX_Mount4.1, P3_XL2.1, P3_XL4.1, P3_XL6.1, P3_XL_Mount2.1, P3_XL_Mount4.1, P3_XL_Mount6.1, R85.2, R87.1, R100.1, R100.2, T2.18 (B1)
unnamed: C1.1, U1.2 (BOOT)
unnamed: C1.2, L1.1, Q1.1 (D), U1.1 (SW)
unnamed: C2.1, U2.2 (BOOT)
unnamed: C2.2, L2.1, Q2.1 (D), U2.1 (SW)
unnamed: C3.1, U3.2 (BOOT)
unnamed: C3.2, L3.1, Q3.1 (D), U3.1 (SW)
unnamed: C4.1, C5.1, C6.1, D1.1 (K), F1.1, FMount2.1, L1.2, R7.1
unnamed: C7.1, C8.1, C9.1, D2.1 (K), F2.1, FMount1.1, L2.2, R9.1
unnamed: C12.1, U1.3 (VCC)
unnamed: C14.1, U2.3 (VCC)
unnamed: C16.1, U3.3 (VCC)
unnamed: C17.1, U4.2 (BOOT)
unnamed: C17.2, L4.1, Q4.1 (D), U4.1 (SW)
unnamed: C18.1, U5.2 (BOOT)
unnamed: C18.2, L5.1, Q5.1 (D), U5.1 (SW)
unnamed: C19.1, C20.1, C21.1, D9.1 (K), F3.1, FMount4.1, L4.2, R22.1
unnamed: C22.1, C23.1, C24.1, D10.1 (K), F4.1, FMount3.1, L5.2, R24.1
unnamed: C26.1, U4.3 (VCC)
unnamed: C28.1, U5.3 (VCC)
unnamed: C29.1, U6.2 (BOOT)
unnamed: C29.2, L6.1, Q8.1 (D), U6.1 (SW)
unnamed: C30.1, U7.2 (BOOT)
unnamed: C30.2, L7.1, Q9.1 (D), U7.1 (SW)
unnamed: C31.1, C32.1, C33.1, D17.1 (K), F7.1, FMount7.1, L6.2, R36.1
unnamed: C34.1, C35.1, C36.1, D18.1 (K), F8.1, FMount8.1, L7.2, R38.1
unnamed: C38.1, U6.3 (VCC)
unnamed: C40.1, U7.3 (VCC)
unnamed: C41.1, U8.2 (BOOT)
unnamed: C41.2, L8.1, Q10.1 (D), U8.1 (SW)
unnamed: C42.1, U9.2 (BOOT)
unnamed: C42.2, L9.1, Q11.1 (D), U9.1 (SW)
unnamed: C43.1, C44.1, C45.1, D23.1 (K), F9.1, FMount9.1, L8.2, R48.1
unnamed: C46.1, C47.1, C48.1, D24.1 (K), F10.1, FMount10.1, L9.2, R50.1
unnamed: C50.1, U8.3 (VCC)
unnamed: C52.1, U9.3 (VCC)
unnamed: C53.1, U10.2 (BOOT)
unnamed: C53.2, L10.1, Q12.1 (D), U10.1 (SW)
unnamed: C54.1, U11.2 (BOOT)
unnamed: C54.2, L11.1, Q13.1 (D), U11.1 (SW)
unnamed: C60.1, U10.3 (VCC)
unnamed: C62.1, U11.3 (VCC)
unnamed: C63.1, U12.2 (BOOT)
unnamed: C63.2, L12.1, Q22.1 (D), U12.1 (SW)
unnamed: C64.1, U13.2 (BOOT)
unnamed: C64.2, L13.1, Q23.1 (D), U13.1 (SW)
unnamed: C65.1, D39.1 (K), F17.1, FMount17.1, L12.2, R76.1
unnamed: C66.1, D40.1 (K), F18.1, FMount18.1, L13.2, R78.1
unnamed: C68.1, U12.3 (VCC)
unnamed: C70.1, U13.3 (VCC)
unnamed: C79.1, C80.1, L14.1, M1.12 (VCORE)
unnamed: C81.1, C82.1, L15.1, M2.12 (VCORE)
unnamed: C83.1, C84.1, M1.13 (DVCC1), R88.1
unnamed: C85.1, C86.1, M2.13 (DVCC1), R89.1
unnamed: D4.2 (A), R1.2
unnamed: D5.2 (A), R3.2
unnamed: D6.2 (A), R8.2
unnamed: D7.2 (A), R10.2
unnamed: D8.2 (A), R5.2
unnamed: D11.2 (A), R18.2
unnamed: D12.2 (A), R20.2
unnamed: D13.2 (A), R23.2
unnamed: D14.2 (A), R25.2
unnamed: D15.2 (A), R30.2
unnamed: D16.2 (A), R31.2
unnamed: D19.2 (A), R32.2
unnamed: D20.2 (A), R34.2
unnamed: D21.2 (A), R37.2
unnamed: D22.2 (A), R39.2
unnamed: D25.2 (A), R44.2
unnamed: D26.2 (A), R46.2
unnamed: D27.2 (A), R49.2
unnamed: D28.2 (A), R51.2
unnamed: D31.2 (A), R53.2
unnamed: D32.2 (A), R55.2
unnamed: D33.2 (A), R66.2
unnamed: D34.2 (A), R67.2
unnamed: D35.2 (A), R68.2
unnamed: D36.2 (A), R69.2
unnamed: D37.2 (A), R70.2
unnamed: D38.2 (A), R71.2
unnamed: D41.2 (A), R72.2
unnamed: D42.2 (A), R74.2
unnamed: D43.2 (A), R77.2
unnamed: D44.2 (A), R79.2
unnamed: F5.2, FMount5.2, Q6.2 (D), R30.1
unnamed: F6.2, FMount6.2, Q7.2 (D), R31.1
unnamed: F11.2, FMount12.2, Q16.2 (D), R66.1
unnamed: F12.2, FMount13.2, Q17.2 (D), R67.1
unnamed: F13.2, FMount11.2, Q19.2 (D), R69.1
unnamed: F14.2, FMount14.2, Q21.2 (D), R71.1
unnamed: F15.2, FMount15.2, Q20.2 (D), R70.1
unnamed: F16.2, FMount16.2, Q18.2 (D), R68.1
unnamed: L14.2, M1.14 (VSW)
unnamed: L15.2, M2.14 (VSW)
unnamed: M1.17 (DIRECTION), R91.1
unnamed: M1.18 (UART_RX), T1.3 (A2)
unnamed: M1.19 (UART_TX), T1.2 (A1)
unnamed: M2.17 (DIRECTION), R90.1
unnamed: M2.18 (UART_RX), T2.3 (A2)
unnamed: M2.19 (UART_TX), T2.2 (A1)
unnamed: Q1.2 (G), U1.4 (BG)
unnamed: Q2.2 (G), U2.4 (BG)
unnamed: Q3.2 (G), U3.4 (BG)
unnamed: Q4.2 (G), U4.4 (BG)
unnamed: Q5.2 (G), U5.4 (BG)
unnamed: Q8.2 (G), U6.4 (BG)
unnamed: Q9.2 (G), U7.4 (BG)
unnamed: Q10.2 (G), U8.4 (BG)
unnamed: Q11.2 (G), U9.4 (BG)
unnamed: Q12.2 (G), U10.4 (BG)
unnamed: Q13.2 (G), U11.4 (BG)
unnamed: Q22.2 (G), U12.4 (BG)
unnamed: Q23.2 (G), U13.4 (BG)
unnamed: R11.2, R17.1, U3.6 (FB)
unnamed: R2.2, R12.1, U1.7 (EN)
unnamed: R4.2, R13.1, U2.7 (EN)
unnamed: R6.2, R14.1, U3.7 (EN)
unnamed: R7.2, R15.1, U1.6 (FB)
unnamed: R9.2, R16.1, U2.6 (FB)
unnamed: R19.2, R26.1, U4.7 (EN)
unnamed: R21.2, R27.1, U5.7 (EN)
unnamed: R22.2, R28.1, U4.6 (FB)
unnamed: R24.2, R29.1, U5.6 (FB)
unnamed: R33.2, R40.1, U6.7 (EN)
unnamed: R35.2, R41.1, U7.7 (EN)
unnamed: R36.2, R42.1, U6.6 (FB)
unnamed: R38.2, R43.1, U7.6 (FB)
unnamed: R45.2, R52.1, U8.7 (EN)
unnamed: R47.2, R57.1, U9.7 (EN)
unnamed: R48.2, R59.1, U8.6 (FB)
unnamed: R50.2, R61.1, U9.6 (FB)
unnamed: R54.2, R62.1, U10.7 (EN)
unnamed: R56.2, R63.1, U11.7 (EN)
unnamed: R58.2, R64.1, U10.6 (FB)
unnamed: R60.2, R65.1, U11.6 (FB)
unnamed: R73.2, R80.1, U12.7 (EN)
unnamed: R75.2, R81.1, U13.7 (EN)
unnamed: R76.2, R82.1, U12.6 (FB)
unnamed: R78.2, R83.1, U13.6 (FB)
unnamed: R86.2, T1.17 (B2)
unnamed: R87.2, T2.17 (B2)
unnamed: R90.2, T2.1 (DIR)
unnamed: R91.2, T1.1 (DIR)
R_Signal: P3_AXMX1.1, P3_AXMX3.1, P3_AXMX_Mount2.1, P3_AXMX_Mount3.1, P3_XL1.1, P3_XL3.1, P3_XL5.1, P3_XL_Mount1.1, P3_XL_Mount3.1, P3_XL_Mount5.1, R84.2, R86.1, R92.1, R92.2, R97.1, R97.2, T1.18 (B1)
VSS: C11.1, C13.1, C15.1, C25.1, C27.1, C37.1, C39.1, C49.1, C51.1, C59.1, C61.1, C67.1, C69.1, P4_VSS1.1, P4_VSS1.2, P4_VSS1.3, P4_VSS1.4, P4_VSS2.1, P4_VSS2.2, P4_VSS2.3, P4_VSS2.4, P4_VSS3.1, P4_VSS3.2, P4_VSS3.3, P4_VSS3.4, P4_VSS_Mount1.1, P4_VSS_Mount1.2, P4_VSS_Mount1.3, P4_VSS_Mount1.4, P4_VSS_Mount2.1, P4_VSS_Mount2.2, P4_VSS_Mount2.3, P4_VSS_Mount2.4, P4_VSS_Mount3.1, P4_VSS_Mount3.2, P4_VSS_Mount3.3, P4_VSS_Mount3.4, R1.1, R2.1, R3.1, R4.1, R5.1, R6.1, R18.1, R19.1, R20.1, R21.1, R32.1, R33.1, R34.1, R35.1, R44.1, R45.1, R46.1, R47.1, R53.1, R54.1, R55.1, R56.1, R72.1, R73.1, R74.1, R75.1, U1.8 (VIN), U2.8 (VIN), U3.8 (VIN), U4.8 (VIN), U5.8 (VIN), U6.8 (VIN), U7.8 (VIN), U8.8 (VIN), U9.8 (VIN), U10.8 (VIN), U11.8 (VIN), U12.8 (VIN), U13.8 (VIN)

Notes on the sheet:
Left Arm MX's
Left and Right Arm AX's
Left Arm XL's
5V Rail
3.3V Rail
MSP432 Signal Circuit
PCB Mounting Purposes
Rightt Arm MX's
PCB Mounting Purposes
Rightt Arm XL's
PCB Power Inputs

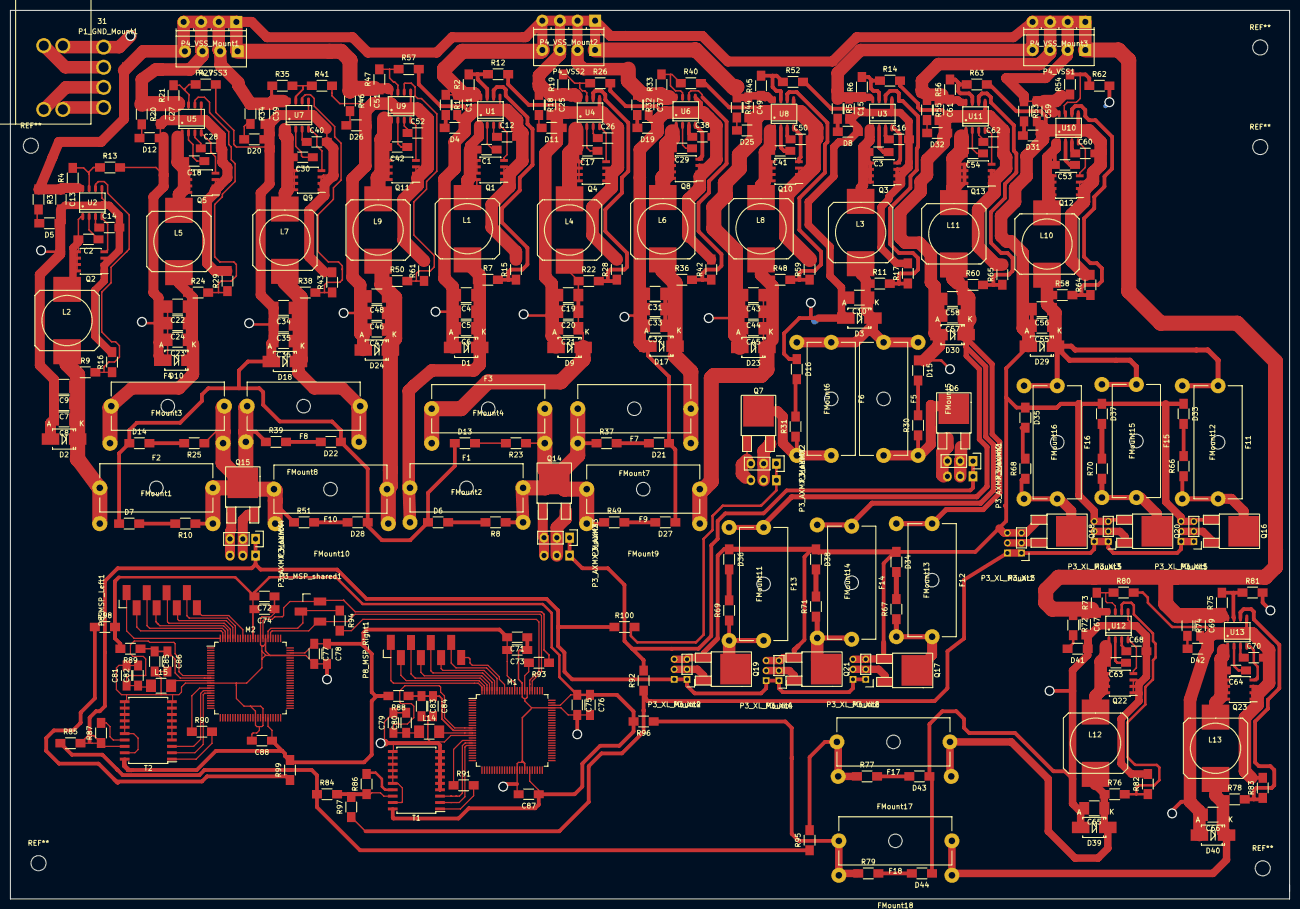
[picture p5: board PCBFinal.kicad_pcb from above]

Board: 2 copper layers, 254.5 x 176.8 mm, 354 parts (0 on the bottom side), 183 nets.
